fkcurrie/warre-hive-cnc/README.md

# Warre Hive CNC SVG Files

This repository contains SVG files for CNC cutting parts to build a Warre hive for beekeeping. The parts are designed to be cut from a single piece of pine board, such as the [Irving 1-inch x 12-inch x 8-ft Rough Knotty Pine Board](https://www.homedepot.ca/product/irving-1-inch-x-12-inch-x-8-ft-rough-knotty-pine-board/1000113397).

## Contents

- `base_2_parts_23_5.svg`: SVG file for the base parts of the hive.
- `roof_parts1_23_5.svg`: SVG file for the roof parts of the hive.
- `warre_small_box_23.5mmx10in.svg`: SVG file for the small box (super) of the hive.
- `warre-hive-roof_23_5.svg`: SVG file for the hive roof.
- `ESTLCAM_Project Files/`: Example ESTLCAM v11 project files showing cut types (pocket/part) and depth settings for reference.
    - `base_2_parts_23_5.e10`: ESTLCAM v11 project for the base parts
    - `roof_parts1_23_5.e10`: ESTLCAM v11 project for the roof parts
    - `warre_small_box_23.5mmx10in.e10`: ESTLCAM v11 project for the small box (super)
    - `bars_7.nc`: Example G-code output for CNC machines

## Usage

1. Obtain a suitable pine board (1" x 12" x 8').
2. Use a CNC machine to cut the parts from the SVG files.
3. Assemble the cut pieces to build a complete Warre hive.
4. Refer to the ESTLCAM project files for examples of how to set up cut types (pocket/part) and appropriate cutting depths in your CNC software.

## Instructional Guide

For step-by-step directions on using Inkscape to create finger joints for CNC machining, see:
- [Instructional Guide: Creating Finger Joints for CNC Machining (PDF)](Documentation/Instructional%20Guide_%20Creating%20Finger%20Joints%20for%20CNC%20Machining.pdf)
- [Live Google Doc version](https://docs.google.com/document/d/1Y7qX6CegrHWxjC8ED7IoqVyE1ZTBiIDg-i6wG8RLdCI)

## More Information

For a detailed discussion of the design process, finger joint techniques, and CNC setup, see the V1 Engineering Forum thread: [Impressed with Finger Joints for Beehives (Warre)](https://forum.v1e.com/t/impressed-with-finger-joints-for-beehives-warre/47693/1)

### Example Photos

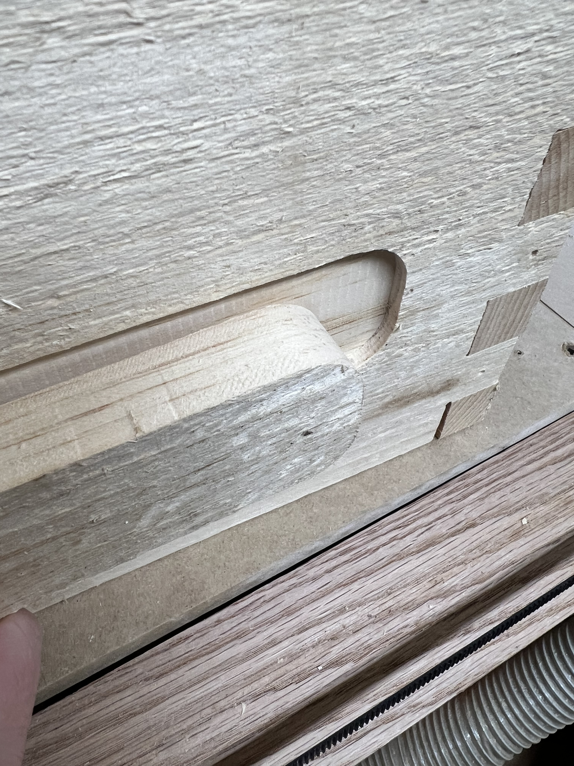
[picture p1: images/443d2574844f79d23d0aaaeaeca64a9b41243d25.jpeg]
Finger jointed Warre hive box 1

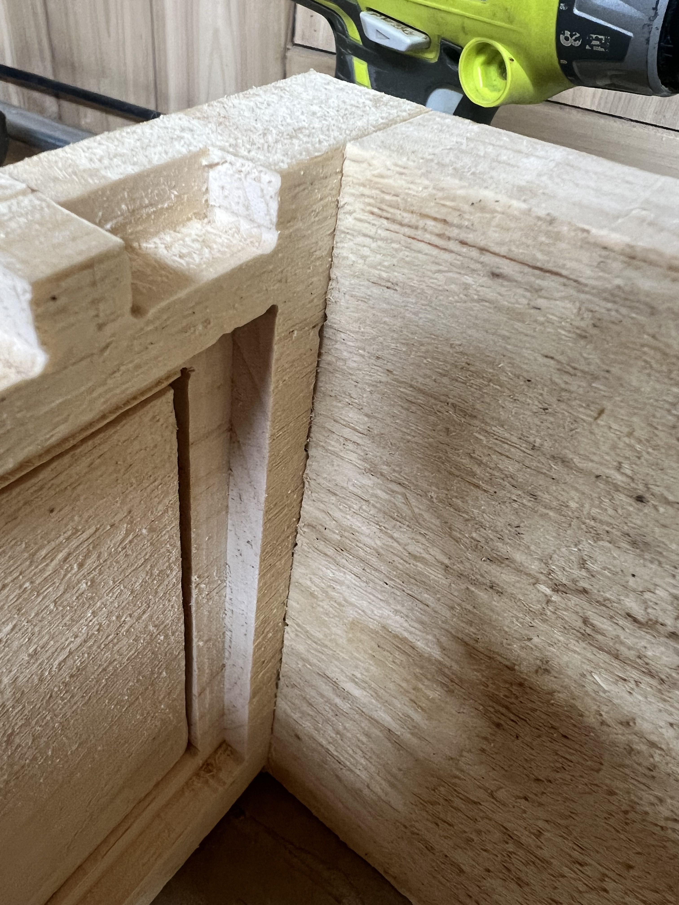
[picture p2: images/24f319c8b937f94452d67235b093487e5ff4e25d.jpeg]
Finger jointed Warre hive box 2

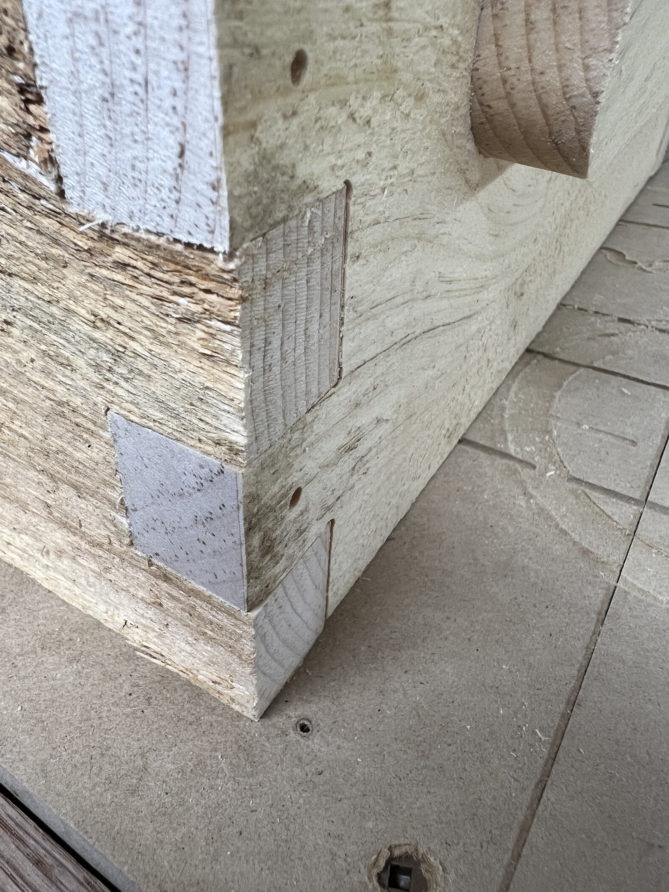
[picture p3: images/110926e7bd35cbe7a05c371a121e99d418c8c284.jpeg]
Finger jointed Warre hive box 3

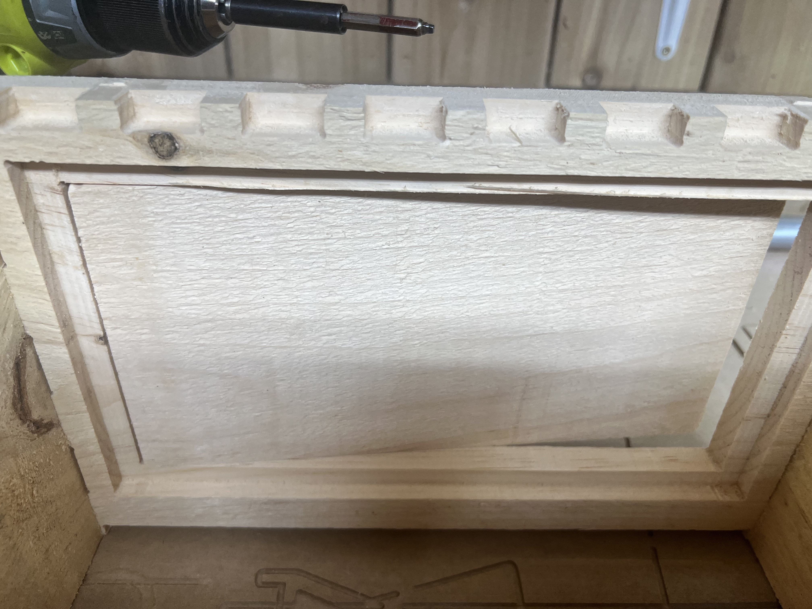
[picture p4: images/ad8b23d9b4bb8a5cd9c794063e8a4e28c2e67e44.jpeg]
Finger jointed Warre hive box 4

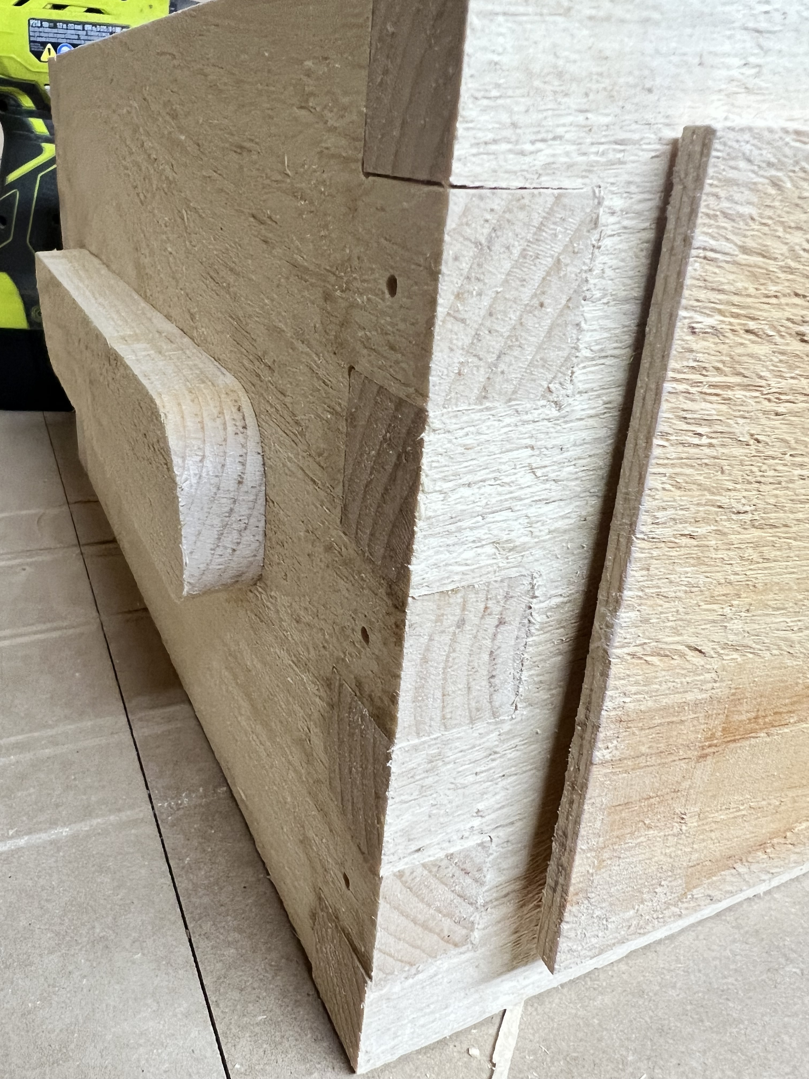
[picture p5: images/e92610142900fcddc8800f9d62076b4aa5bbf4a3.jpeg]
Finger jointed Warre hive box 5


#### End Product Photos

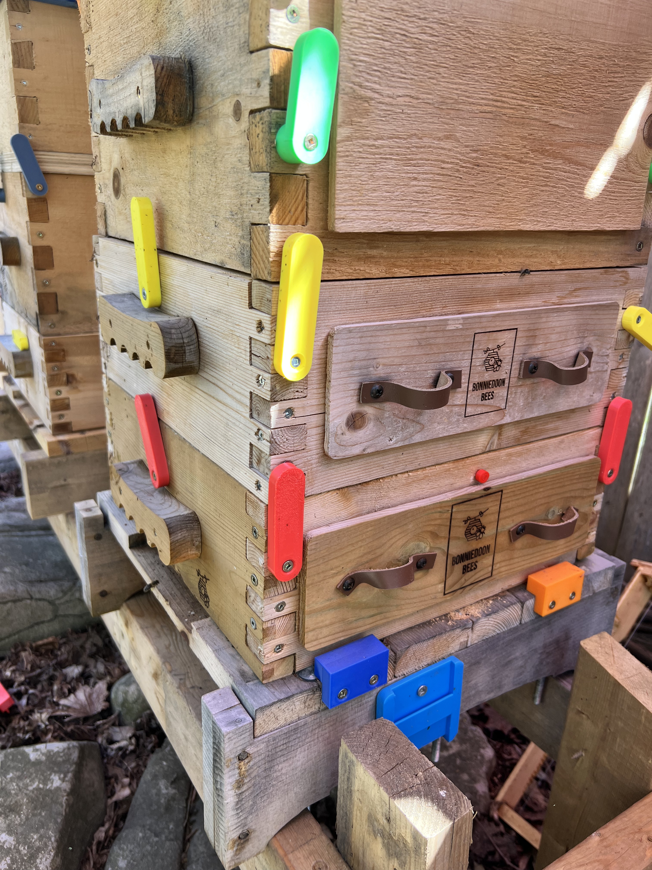
[picture p6: images/IMG_7616.jpg]
Hive Photo 1

Hive Photo 2
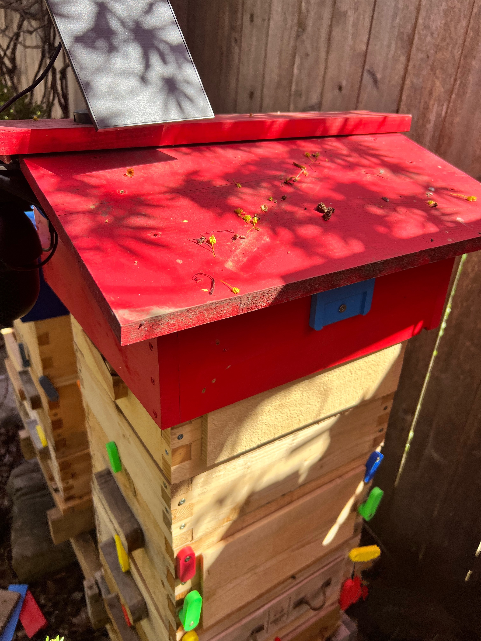
[picture p7: images/IMG_7618.jpg]
Hive Photo 3


### Bees using the Hive

The bees in action:

- [Download and watch IMG_7619.MOV](images/IMG_7619.MOV)
- [Watch on Google Photos](https://photos.app.goo.gl/gFv2ZMfHhT52Lzts6)

## Support

If you find this project useful, please consider supporting it!
