fkcurrie/warre-hive-cnc/(commit log)

2025-05-10 Added bas SVG files for CNC - using 23.5mm pine boards.
2025-05-10 Updated README and linked to v1enginiering thread.
